belovictor/rover6_hardware/frame/ROVER6_FRAME_ASSEMBLY.step

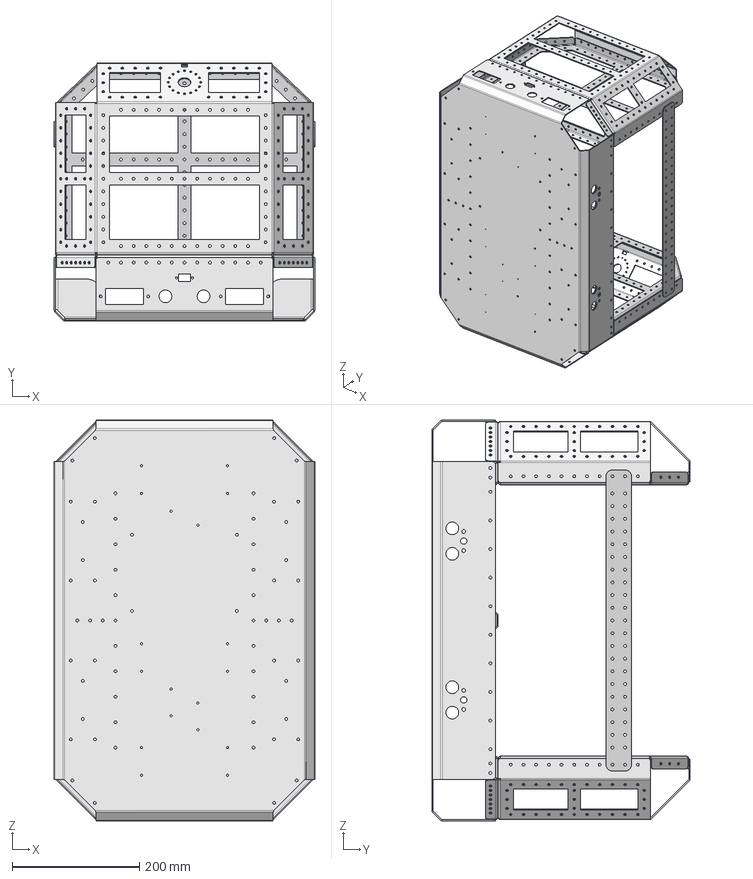
[picture p4: CAD file, 2024-07-21]
frame/ROVER6_FRAME_ASSEMBLY.step
410.0 x 406.2 x 631.1 mm
ROVER6_FRAME_BOTTOM
ROVER6_FRAME_FRONT_REAR_SUPPORT x 2
ROVER6_FRAME_FRONT_REAR_BRAKET x 2
ROVER6_FRAME_FRONT_REAR_PLATE x 2
ROVER6_FRAME_CENTRAL_BRAKET
ROVER6_WHEEL_SUPPORT_BRAKET x 4
ROVER6_FRAME_SIDE_PANEL x 2
