belovictor/rover6_hardware/frame/ROVER6_FRAME_CENTRAL_BRAKET.step

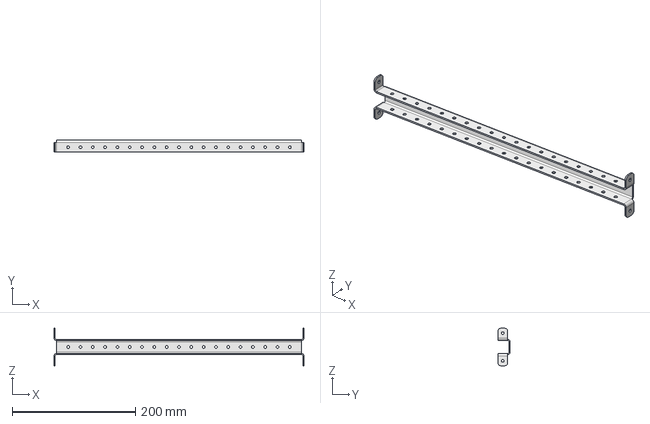
[picture p5: CAD file, 2024-07-21]
frame/ROVER6_FRAME_CENTRAL_BRAKET.step
406.0 x 20.0 x 61.0 mm
