belovictor/rover6_hardware/frame/ROVER6_FRAME_SIDE_PANEL.step

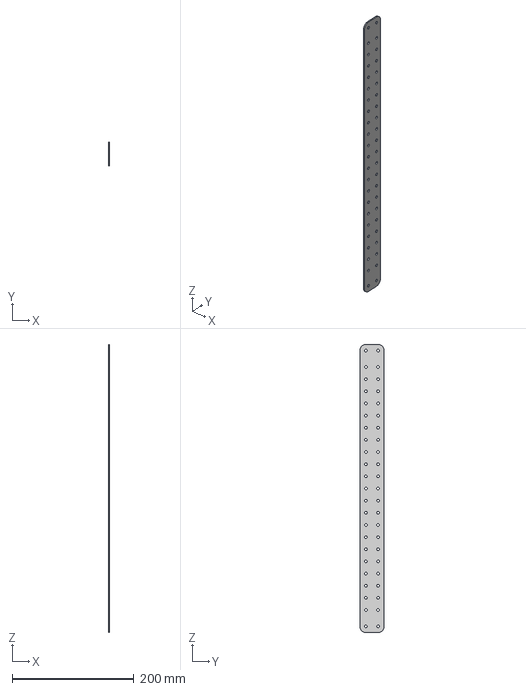
[picture p6: CAD file, 2024-07-21]
frame/ROVER6_FRAME_SIDE_PANEL.step
2.00 x 40.0 x 473.9 mm
