belovictor/rover6_hardware/frame/ROVER6_FRAME_BOTTOM.step

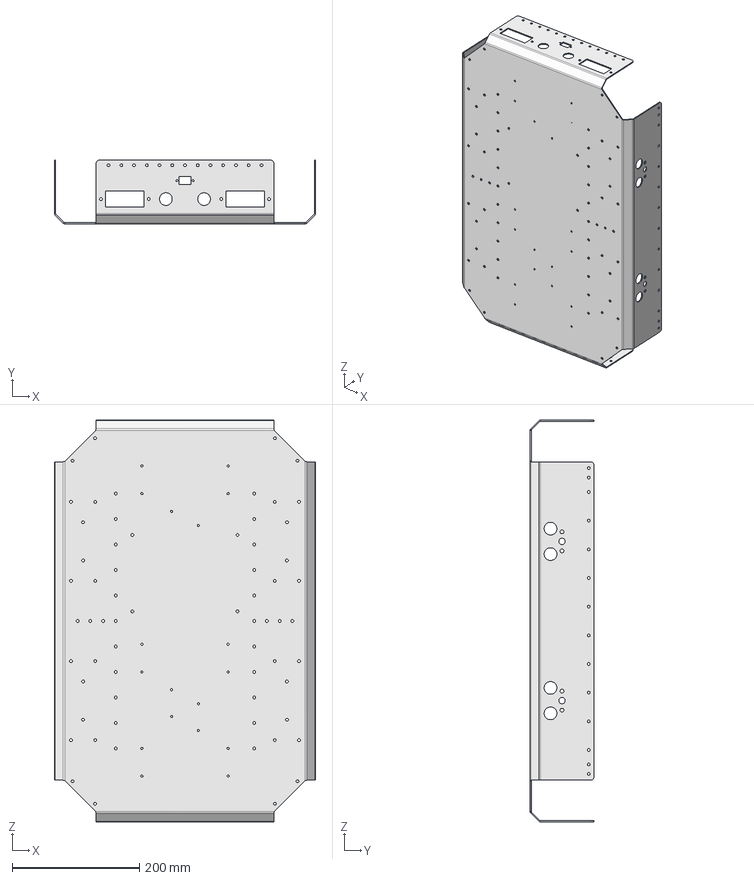
[picture p7: CAD file, 2024-07-21]
frame/ROVER6_FRAME_BOTTOM.step
410.0 x 100.0 x 631.1 mm
