belovictor/rover6_hardware/frame/ROVER6_FRAME_FRONT_REAR_SUPPORT.step

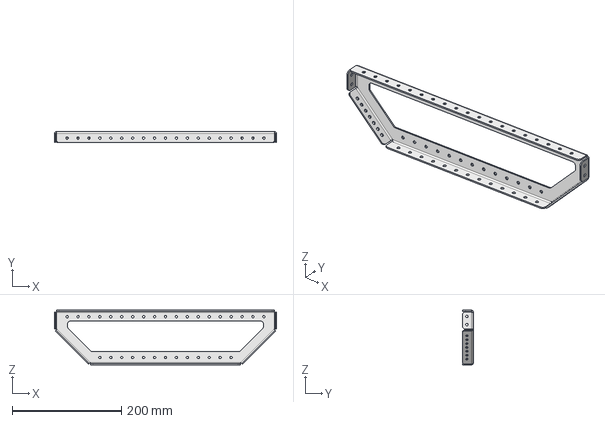
[picture p8: CAD file, 2024-07-21]
frame/ROVER6_FRAME_FRONT_REAR_SUPPORT.step
406.0 x 20.0 x 100.0 mm
