belovictor/rover6_hardware/frame/ROVER6_FRAME_FRONT_REAR_PLATE.step

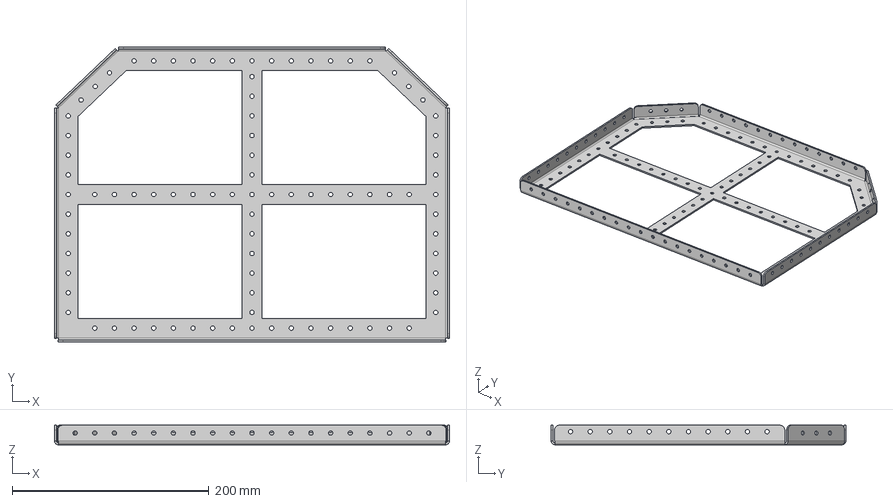
[picture p9: CAD file, 2024-07-21]
frame/ROVER6_FRAME_FRONT_REAR_PLATE.step
402.0 x 300.0 x 20.0 mm
