belovictor/rover6_hardware/frame/ROVER6_WHEEL_SUPPORT_BRAKET.step

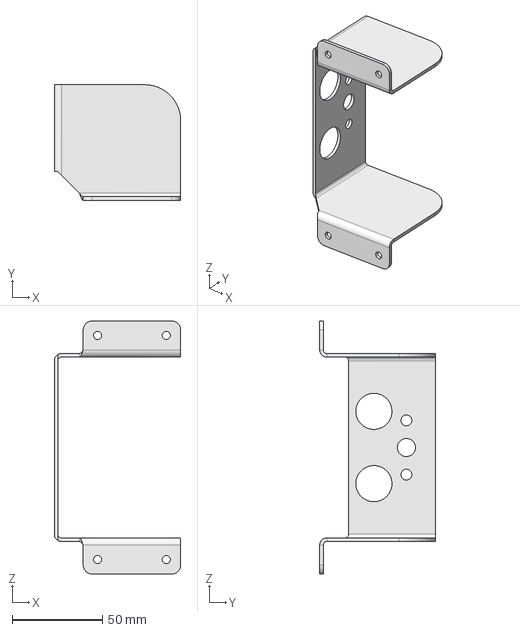
[picture p10: CAD file, 2024-07-21]
frame/ROVER6_WHEEL_SUPPORT_BRAKET.step
70.0 x 64.0 x 140.0 mm
