belovictor/rover6_hardware/frame/ROVER6_FRAME_FRONT_REAR_BRAKET.step

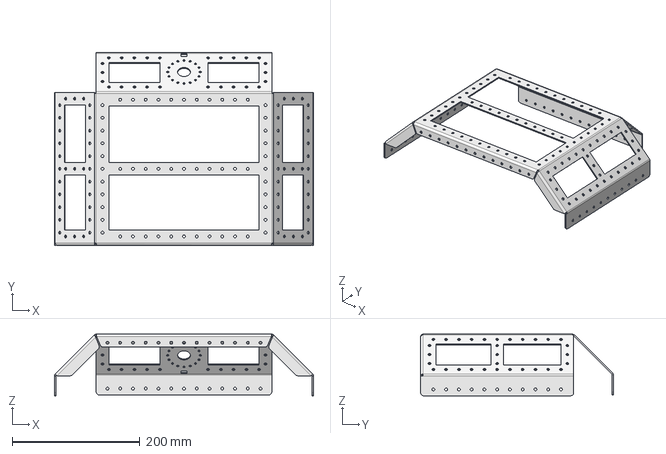
[picture p11: CAD file, 2024-07-21]
frame/ROVER6_FRAME_FRONT_REAR_BRAKET.step
406.0 x 302.2 x 96.6 mm
