belovictor/rover6_hardware/(list of files, cad)

Other CAD files:
frame/ROVER6_FRAME_BOTTOM.dxf
frame/ROVER6_FRAME_CENTRAL_BRAKET.dxf
frame/ROVER6_FRAME_FRONT_REAR_BRAKET.dxf
frame/ROVER6_FRAME_FRONT_REAR_PLATE.dxf
frame/ROVER6_FRAME_FRONT_REAR_SUPPORT.dxf
frame/ROVER6_FRAME_SIDE_PANEL.dxf
frame/ROVER6_WHEEL_SUPPORT_BRAKET.dxf
