belovictor/rover6_hardware/frame/ROVER6_FRAME_FRONT_REAR_PLATE.pdf

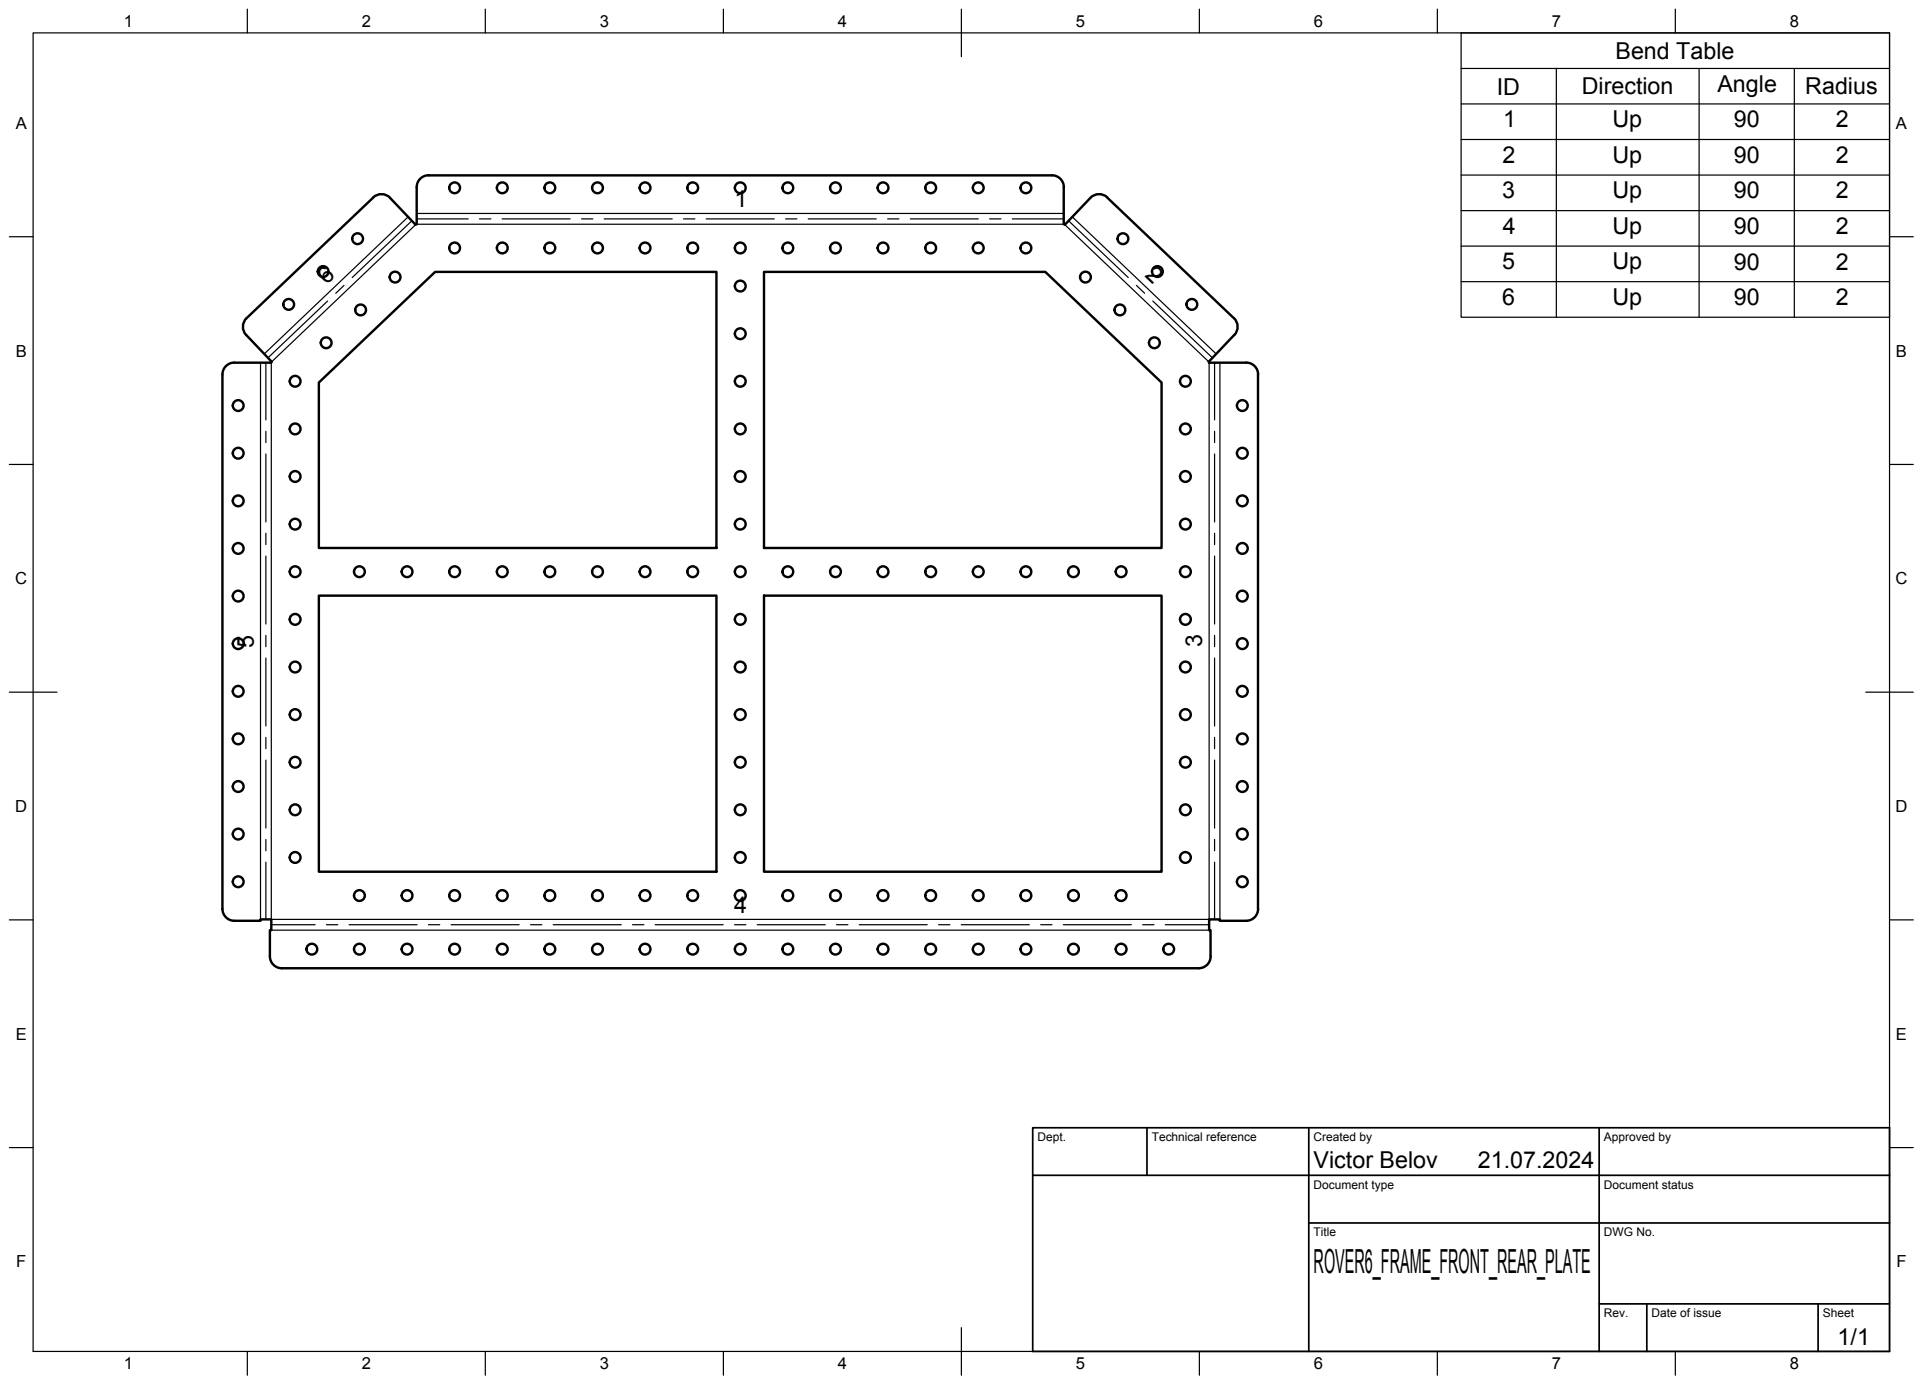
[picture p15: page 1]
Title; DWG No.; Rev.; Date of issue; Sheet; Bend Table

ID | Direction | Angle | Radius
1 | Up | 90 | 2
2 | Up | 90 | 2
3 | Up | 90 | 2
4 | Up | 90 | 2
5 | Up | 90 | 2
6 | Up | 90 | 2

Dept. | Technical reference | Created by Victor Belov 21.07.2024 | Approved by

Document type | Document status
